Yuandiaodiaodiao/a-sample-cpu/README.md

# a-sample-cpu  
计组课设 mips五级流水原型机 带汇编编译器  
文件夹结构  
实验一 t1  
实验二 t2  
实验三 t3  
实验四 t6  
汇编器 bintohex.py
