Yuandiaodiaodiao/a-sample-cpu/doc/assets/Block7.jpg

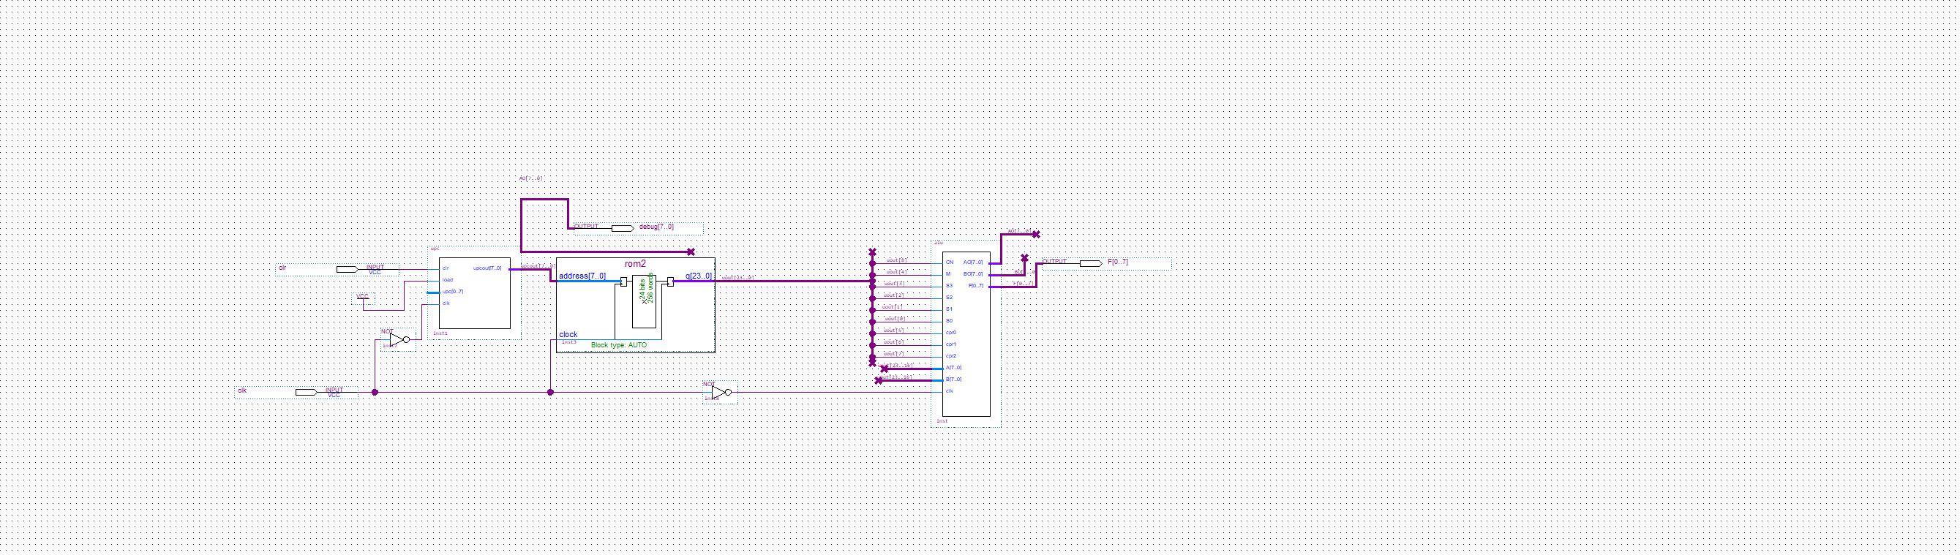
doc/assets/Block7.jpg
