Yuandiaodiaodiao/a-sample-cpu/(list of files, cad)

Other CAD files:
t3/simulation/modelsim/gate_work/cpu/verilog.psm
t3/simulation/modelsim/gate_work/cpu_vlg_tst/verilog.psm
t3/simulation/modelsim/rtl_work/cpu/verilog.psm
t3/simulation/modelsim/rtl_work/cpu_vlg_tst/verilog.psm
