Yuandiaodiaodiao/a-sample-cpu/(commit log)

2019-11-12 add t6 available
    [op.xlsx, 华莱士.xlsx, 微指令.xlsx, 指令.xlsx]
2019-11-13 t6仿真成功
    [op.xlsx]
2019-11-13 update div t6
    [op.xlsx, 微指令.xlsx]
2019-12-07 final version
    [计组课设苑宗鹤.xlsx]
2019-12-08 add doc
    [微指令.xlsx, 计组课设苑宗鹤.xlsx]
